avlepage/Glove-PCB/rendered_pcb.png

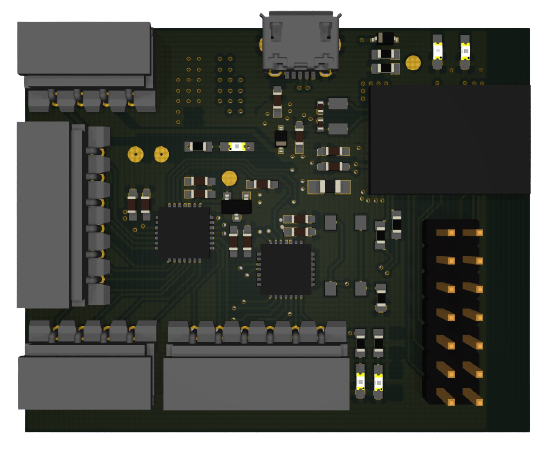
rendered_pcb.png
