avlepage/Glove-PCB/3D/10118194c.stp

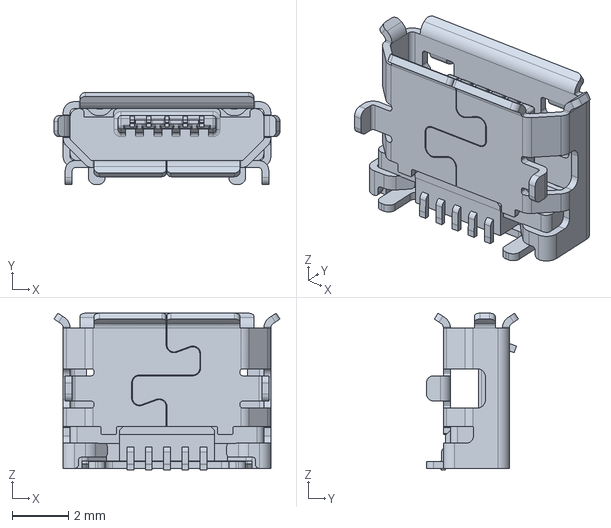
[picture p2: CAD file, 2020-12-24]
3D/10118194c.stp
8.05 x 3.27 x 5.58 mm
