avlepage/Glove-PCB/3D/022057045.stp

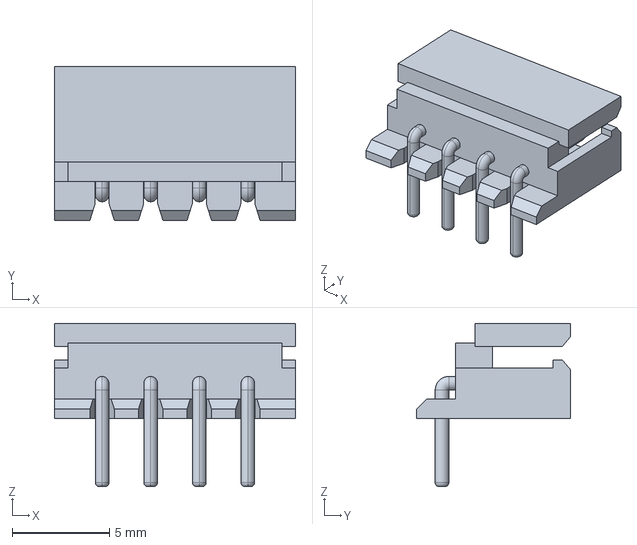
[picture p3: CAD file, 2020-12-24]
3D/022057045.stp
12.4 x 7.90 x 8.40 mm
