avlepage/Glove-PCB/3D/022057065.stp

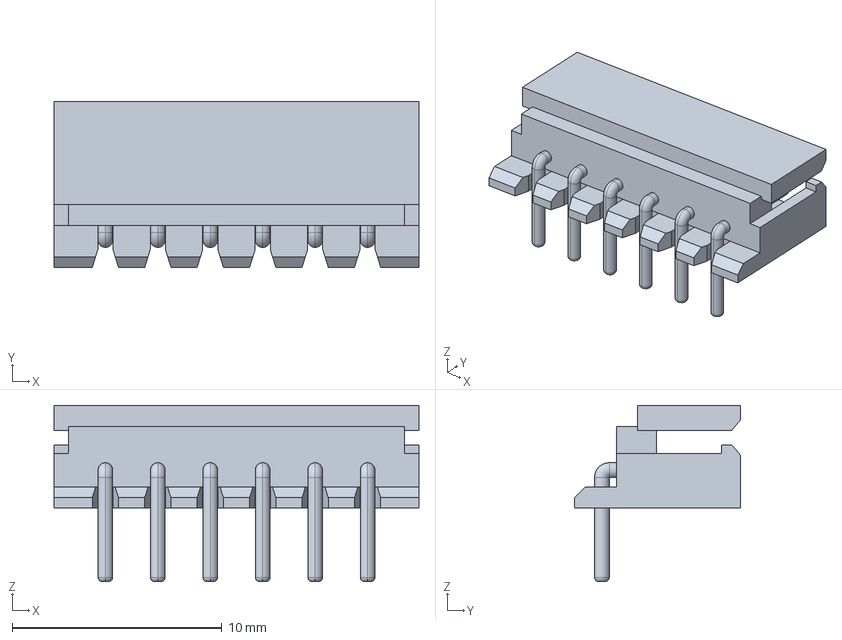
[picture p4: CAD file, 2020-12-24]
3D/022057065.stp
17.4 x 7.90 x 8.40 mm
