avlepage/Glove-PCB/Glove PCB.kicad_pcb

## KiCad design Glove PCB.kicad_pcb (2021-01-22)

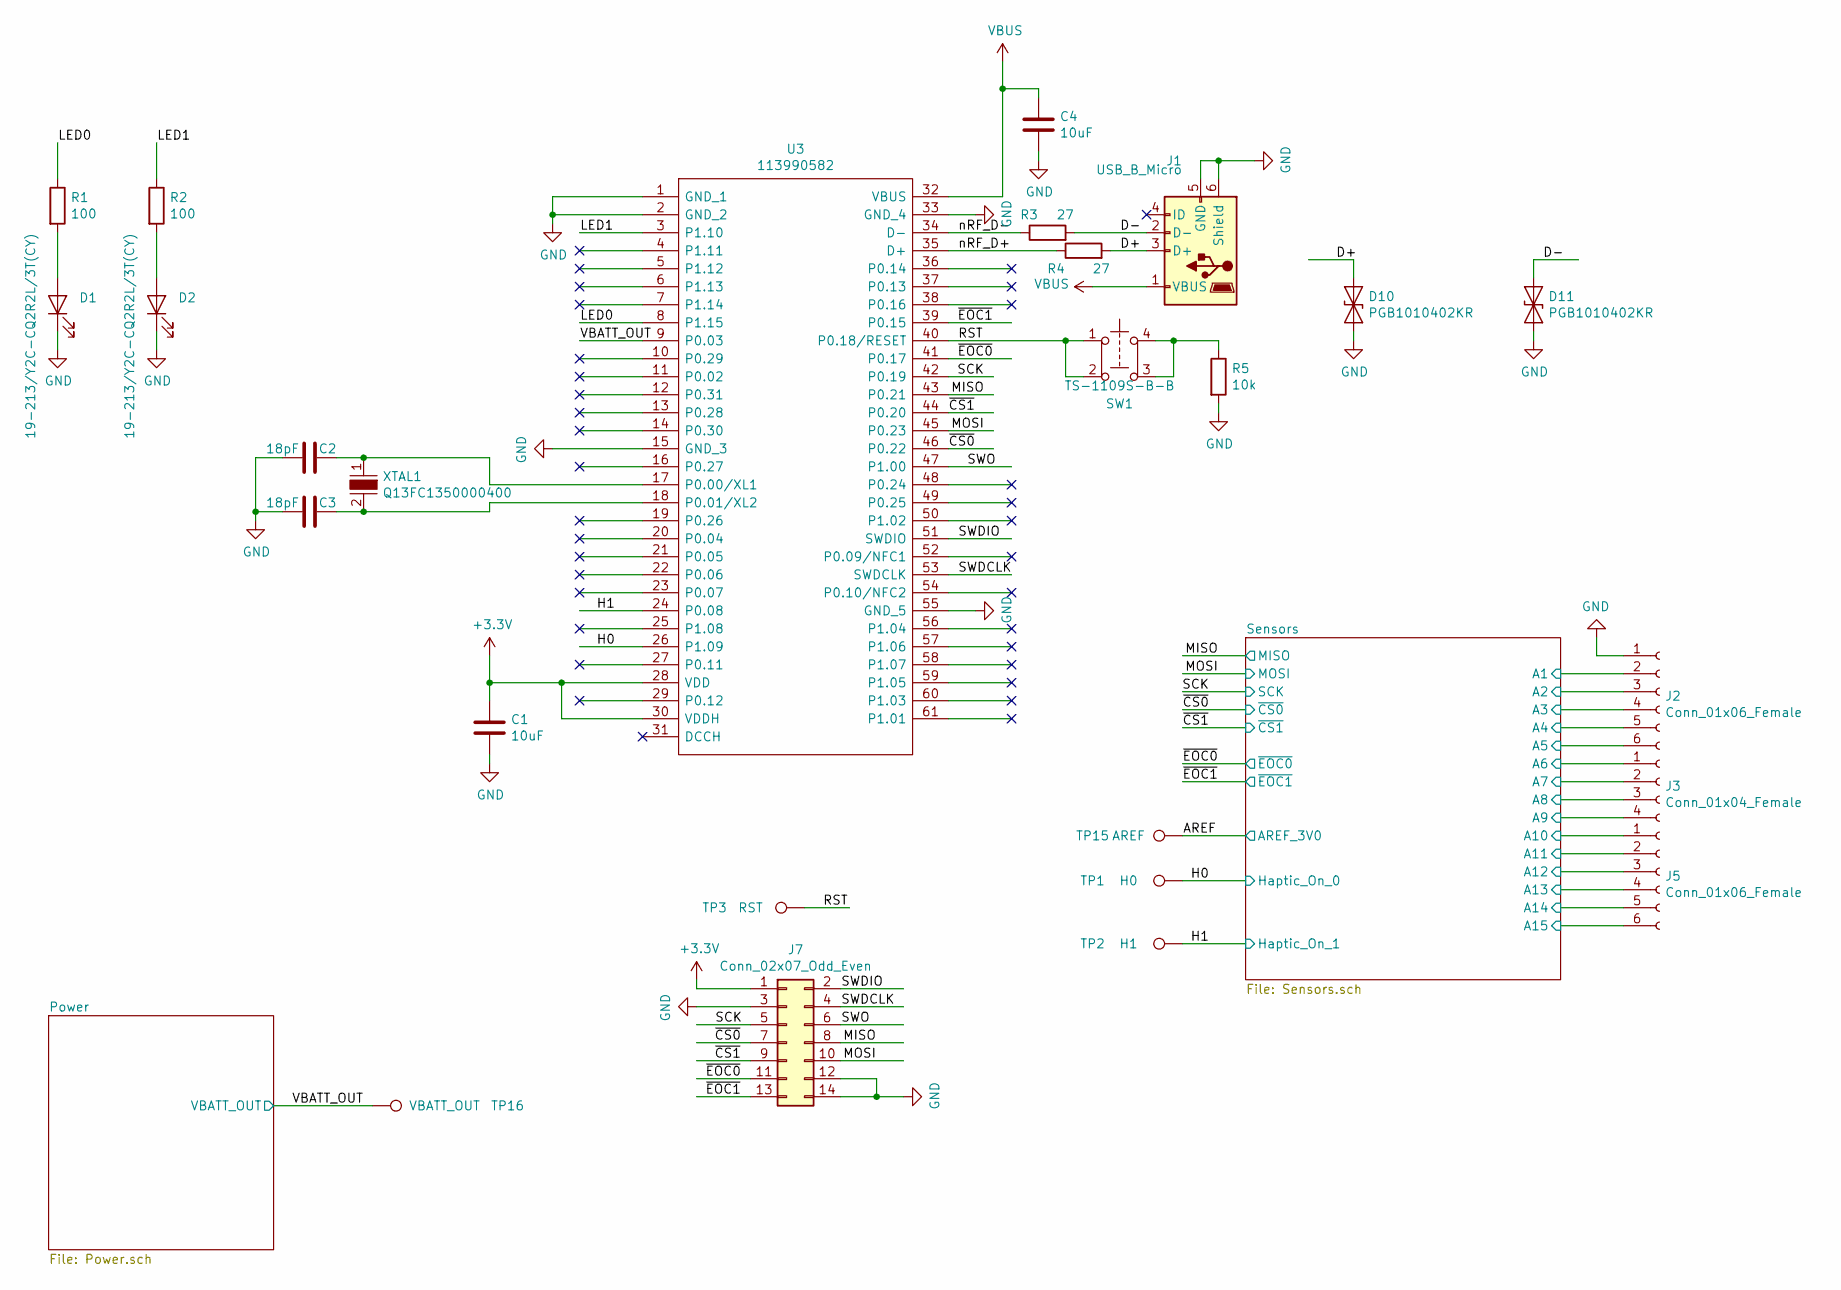
[picture p5: schematic Glove PCB.sch]

Parts:
C1, C4: 10uF; C_0603_HandSoldering; MPN CL10A106KP8NNNC; LCSC C19702
C2, C3: 18pF; C_0402; MPN 0402CG180J500NT; LCSC C1549
D1, D2: 19-213/Y2C-CQ2R2L/3T(CY); LED_0603_HandSoldering; MPN 19-213/Y2C-CQ2R2L/3T(CY); LCSC C72038
D10, D11: PGB1010402KR; D_0402_1005Metric; MPN PGB1010402KR; LCSC C10676
J1: USB_B_Micro; USB_Micro-B_10118194-0001LF
J2, J5: Conn_01x06_Female; 22-05-7065
J3: Conn_01x04_Female; 22-05-7045
J7: Conn_02x07_Odd_Even; PinHeader_2x07_P2.54mm_Vertical
R1, R2: 100; R_0603_HandSoldering; MPN 0603WAF1000T5E; LCSC C22775
R3, R4: 27; R_0603_1608Metric_Pad0.84x1.00mm_HandSolder; MPN 0603WAF270JT5E; LCSC C25190
R5: 10k; R_0402_1005Metric; MPN 0402WGF1002TCE; LCSC C25744
SW1: TS-1109S-B-B; Button; MPN TS-1109S-B-B; LCSC C480315
TP1: H0; TestPoint_Pad_D1.5mm
TP2: H1; TestPoint_Pad_D1.5mm
TP3: RST; TestPoint_Pad_D1.5mm
TP15: AREF; TestPoint_Pad_D1.5mm
TP16: VBATT_OUT; TestPoint_Pad_D1.5mm
U3: 113990582; Mouser Part Number 713-113990582
XTAL1: Q13FC1350000400; Crystal_SMD_G8-2pin_3.2x1.5mm; MPN Q13FC1350000400; Digi-Key_PN XC1617CT-ND

Connections:
+3V3: C1.1, J7.1, U3.28 (VDD), U3.30 (VDDH); also elsewhere on the board
/AREF: TP15.1; also elsewhere on the board
/D+: D10.1 (A1), J1.3 (D+), R4.2
/D-: D11.1 (A1), J1.2 (D-), R3.2
/H0: TP1.1, U3.26 (P1.09); also elsewhere on the board
/H1: TP2.1, U3.24 (P0.08); also elsewhere on the board
/LED0: R1.1, U3.8 (P1.15)
/LED1: R2.1, U3.3 (P1.10)
/MISO: J7.8, U3.43 (P0.21); also elsewhere on the board
/MOSI: J7.10, U3.45 (P0.23); also elsewhere on the board
/RST: SW1.1, SW1.2, TP3.1, U3.40 (P0.18/RESET); also elsewhere on the board
/SCK: J7.5, U3.42 (P0.19); also elsewhere on the board
/SWDCLK: J7.4, U3.53 (SWDCLK)
/SWDIO: J7.2, U3.51 (SWDIO)
/SWO: J7.6, U3.47 (P1.00)
/Sensors/A1: J2.2; also elsewhere on the board
/Sensors/A2: J2.3; also elsewhere on the board
/Sensors/A3: J2.4; also elsewhere on the board
/Sensors/A4: J2.5; also elsewhere on the board
/Sensors/A5: J2.6; also elsewhere on the board
/Sensors/A6: J3.1; also elsewhere on the board
/Sensors/A7: J3.2; also elsewhere on the board
/Sensors/A8: J3.3; also elsewhere on the board
/Sensors/A9: J3.4; also elsewhere on the board
/Sensors/A10: J5.1; also elsewhere on the board
/Sensors/A11: J5.2; also elsewhere on the board
/Sensors/A12: J5.3; also elsewhere on the board
/Sensors/A13: J5.4; also elsewhere on the board
/Sensors/A14: J5.5; also elsewhere on the board
/Sensors/A15: J5.6; also elsewhere on the board
/VBATT_OUT: TP16.1, U3.9 (P0.03); also elsewhere on the board
/nRF_D+: R4.1, U3.35 (D+)
/nRF_D-: R3.1, U3.34 (D-)
/~CS0: J7.7, U3.46 (P0.22); also elsewhere on the board
/~CS1: J7.9, U3.44 (P0.20); also elsewhere on the board
/~EOC0: J7.11, U3.41 (P0.17); also elsewhere on the board
/~EOC1: J7.13, U3.39 (P0.15); also elsewhere on the board
GND: C1.2, C2.2, C3.2, C4.2, D1.1 (K), D2.1 (K), D10.2 (A2), D11.2 (A2), J1.5 (GND), J1.6 (Shield), J2.1, J7.3, J7.12, J7.14, R5.2, U3.1 (GND_1), U3.2 (GND_2), U3.15 (GND_3), U3.33 (GND_4), U3.55 (GND_5); also elsewhere on the board
unnamed: C2.1, U3.17 (P0.00/XL1), XTAL1.1
unnamed: C3.1, U3.18 (P0.01/XL2), XTAL1.2
unnamed: D1.2 (A), R1.2
unnamed: D2.2 (A), R2.2
unnamed: R5.1, SW1.3, SW1.4
VBUS: C4.1, J1.1 (VBUS), U3.32 (VBUS); also elsewhere on the board

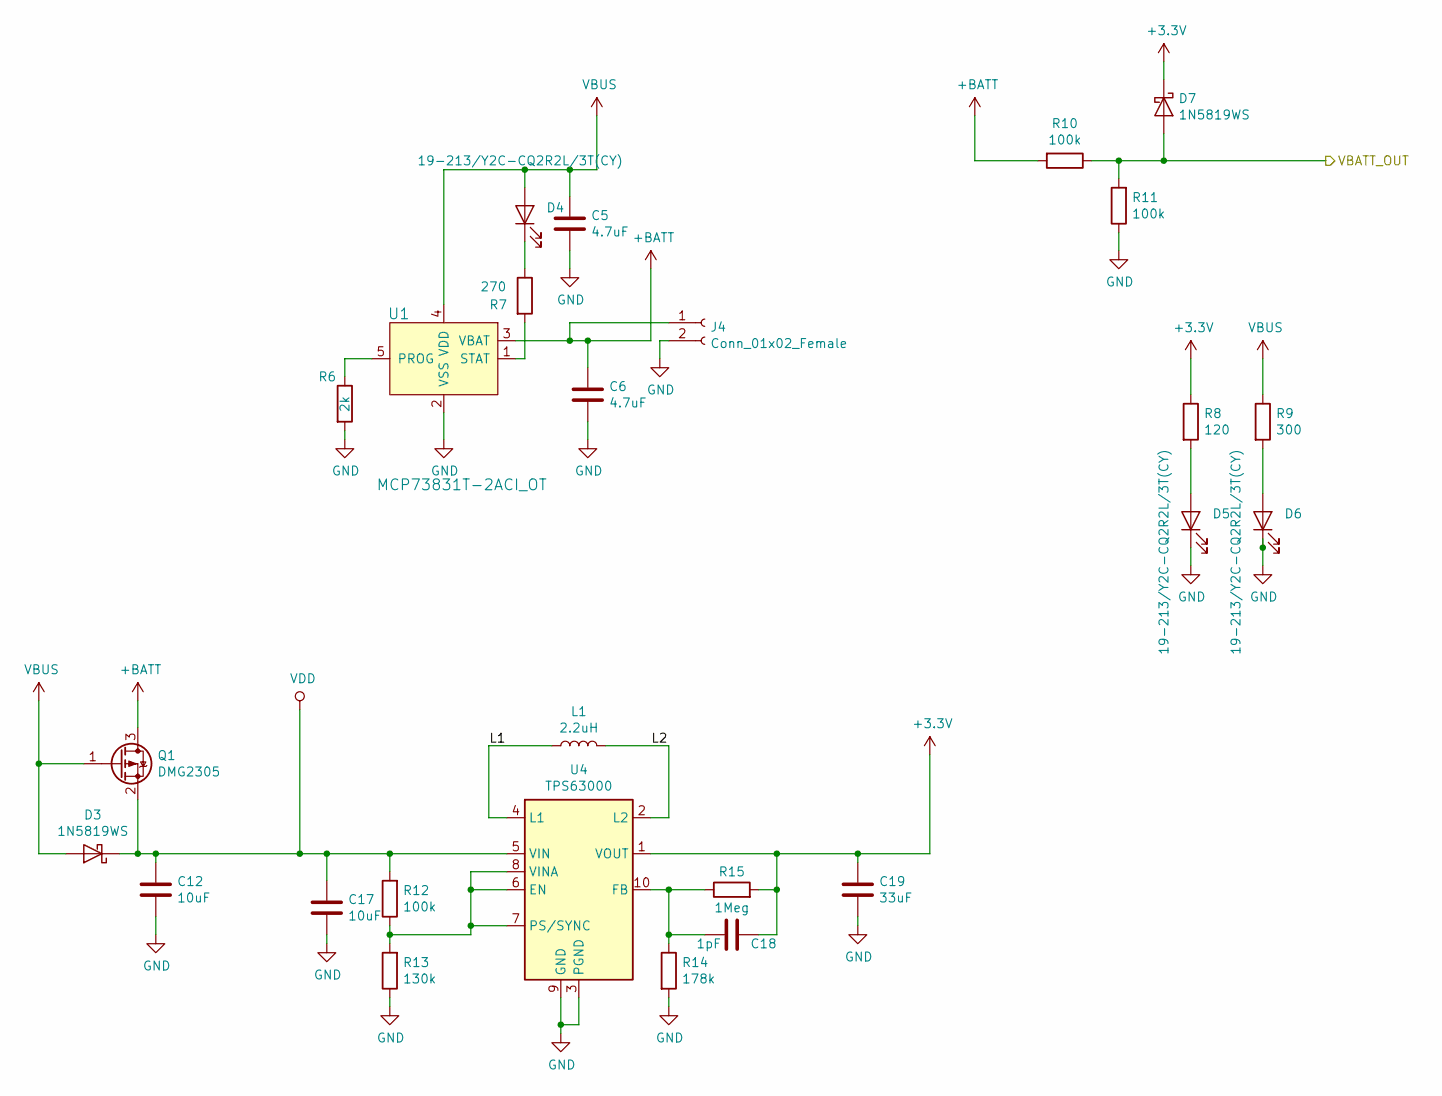
[picture p6: schematic Power.sch]

Parts:
C5, C6: 4.7uF; C_0603_HandSoldering; MPN CL10A475KO8NNNC; LCSC C19666
C12, C17: 10uF; C_0603_HandSoldering; MPN CL10A106KP8NNNC; LCSC C19702
C18: 1pF; C_0603_HandSoldering; MPN CL10C010CB8NNNC; LCSC C23969
C19: 33uF; C_0805_HandSoldering; MPN C2012X5R1A336MTJ00E; LCSC C342635
D3, D7: 1N5819WS; D_SOD-323; MPN 1N5819WS; LCSC C191023
D4, D5, D6: 19-213/Y2C-CQ2R2L/3T(CY); LED_0603_HandSoldering; MPN 19-213/Y2C-CQ2R2L/3T(CY); LCSC C72038
J4: Conn_01x02_Female; JST_PH_B2B-PH-SM4-TB_1x02_P2.00mm_Vertical
L1: 2.2uH; L_0805_HandSoldering; MPN MPH201210S2R2MT; LCSC C55755
Q1: DMG2305; SOT-23; MPN DMG2305UX-13; LCSC C144153
R6: 2k; R_0402_1005Metric; MPN 0402WGF2001TCE; LCSC C4109
R7: 270; R_0603_HandSoldering; MPN 0603WAF2700T5E; LCSC C22966
R8: 120; R_0603_HandSoldering; MPN 0603WAF1200T5E; LCSC C22787
R9: 300; R_0603_HandSoldering; MPN 0603WAF3000T5E; LCSC C23025
R10, R11, R12: 100k; R_0603_HandSoldering; MPN 0603WAF1003T5E; LCSC C25803
R13: 130k; R_0603_HandSoldering; MPN 0603WAF1303T5E; LCSC C22795
R14: 178k; R_0603_HandSoldering; MPN 0603WAF1783T5E; LCSC C22823
R15: 1Meg; R_0603_HandSoldering; MPN 0603WAF1004T5E; LCSC C22935
U1: MCP73831T-2ACI_OT; SOT-753; MPN MCP73831T-2ACI/OT; Digi-Key_PN MCP73831T-2ACI/OTCT-ND
U4: TPS63000; VSON-10-1EP_3x3mm_P0.5mm_EP1.65x2.4mm_ThermalVias; MPN TPS63000DRCR; LCSC C24966

Connections:
+3V3: C18.1, C19.1, D7.1 (K), R8.1, R15.2, U4.1 (VOUT); also elsewhere on the board
+BATT: C6.1, J4.1, Q1.3 (D), R10.2, U1.3 (VBAT)
/Power/L1: L1.1, U4.4 (L1)
/Power/L2: L1.2, U4.2 (L2)
/VBATT_OUT: D7.2 (A), R10.1, R11.2; also elsewhere on the board
GND: C5.2, C6.2, C12.2, C17.2, C19.2, D5.1 (K), D6.1 (K), J4.2, R6.2, R11.1, R13.1, R14.2, U1.2 (VSS), U4.3 (PGND), U4.9 (GND), U4.11 (PGND); also elsewhere on the board
unnamed: C18.2, R14.1, R15.1, U4.10 (FB)
unnamed: D4.1 (K), R7.1
unnamed: D5.2 (A), R8.2
unnamed: D6.2 (A), R9.2
unnamed: R6.1, U1.5 (PROG)
unnamed: R7.2, U1.1 (STAT)
unnamed: R12.1, R13.2, U4.6 (EN), U4.7 (PS/SYNC), U4.8 (VINA)
VBUS: C5.1, D3.2 (A), D4.2 (A), Q1.1 (G), R9.1, U1.4 (VDD); also elsewhere on the board
VDD: C12.1, C17.1, D3.1 (K), Q1.2 (S), R12.2, U4.5 (VIN); also elsewhere on the board

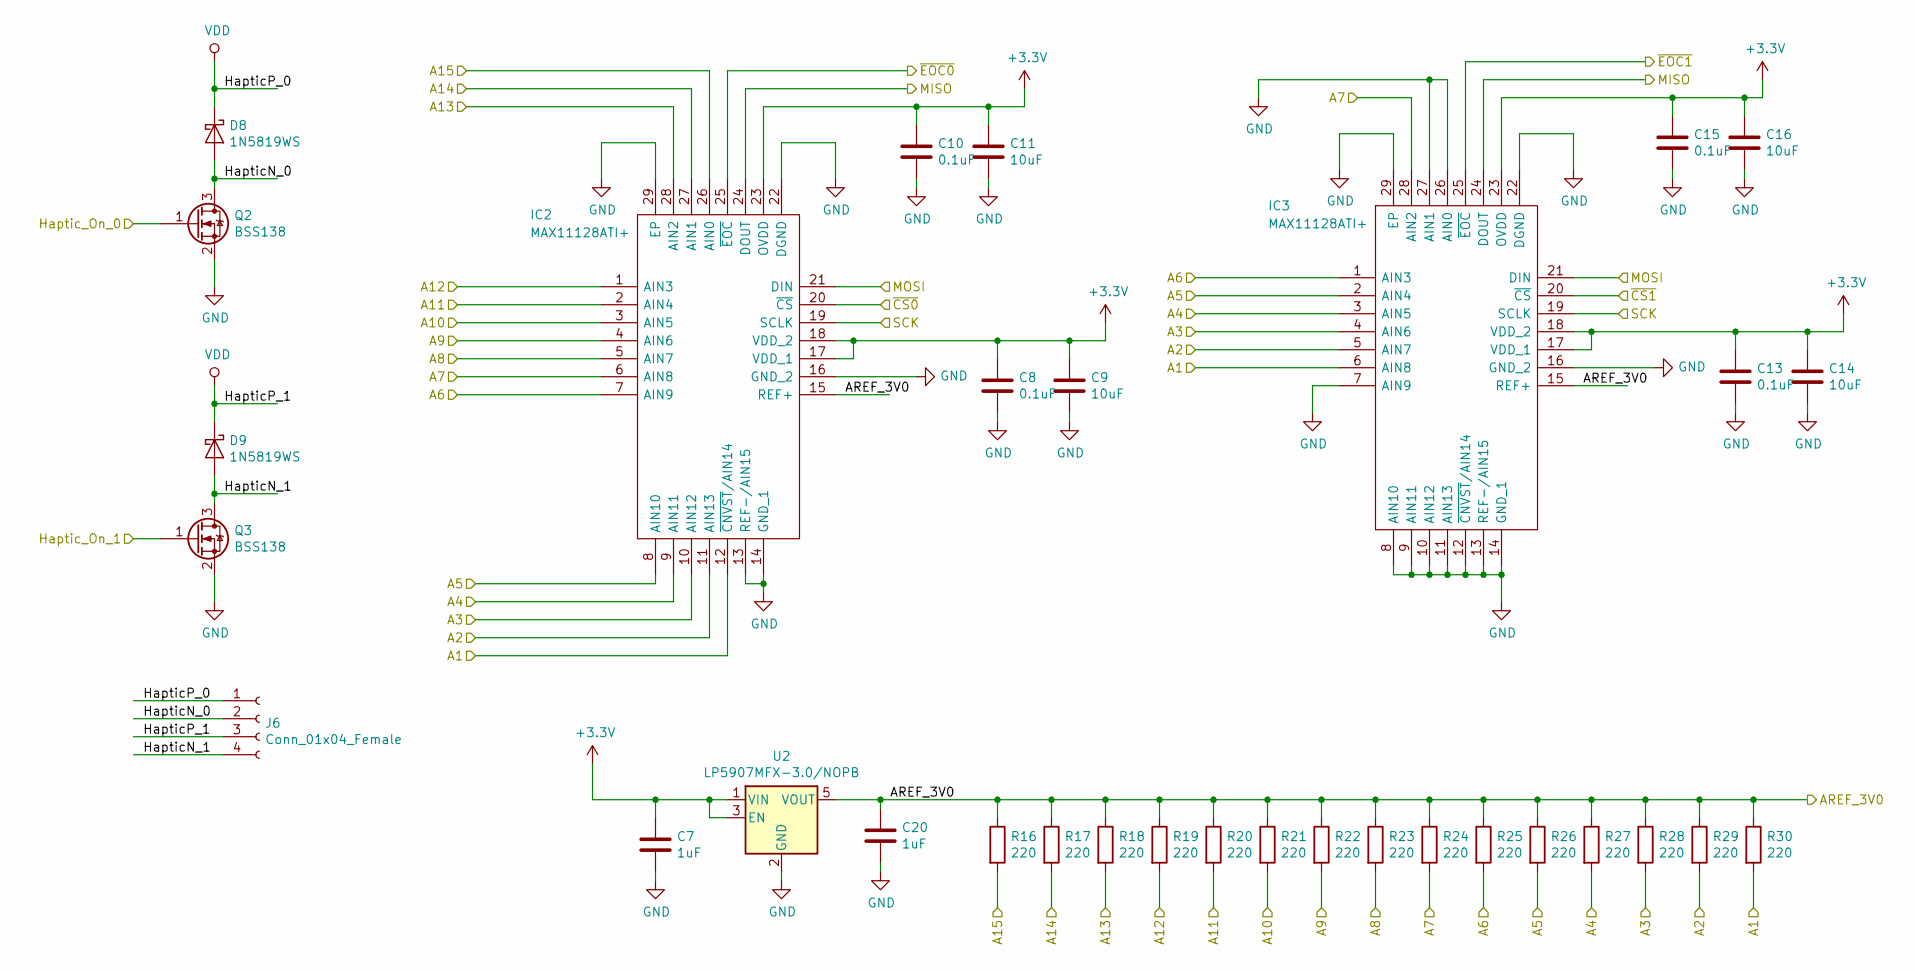
[picture p7: schematic Sensors.sch]

Parts:
C7, C20: 1uF; C_0603_HandSoldering; MPN CL10A105KB8NNNC; LCSC C15849
C8, C10, C13, C15: 0.1uF; C_0603_HandSoldering; MPN CC0603KRX7R9BB104; LCSC C14663
C9, C11, C14, C16: 10uF; C_0603_HandSoldering; MPN CL10A106KP8NNNC; LCSC C19702
D8, D9: 1N5819WS; D_SOD-323; MPN 1N5819WS; LCSC C191023
IC2, IC3: MAX11128ATI+; QFN50P500X500X80-29N; Mouser Part Number 700-MAX11128ATI+
J6: Conn_01x04_Female; 22-05-7045
Q2, Q3: BSS138; SOT-23; MPN BSS138; LCSC C52895
R16, R17, R18, R19, R20, R21, R22, R23, R24, R25, R26, R27, R28, R29, R30: 220; R_0603_HandSoldering; MPN 0603WAF2200T5E; LCSC C22962
U2: LP5907MFX-3.0/NOPB; SOT-23-5; MPN LP5907MFX-3.0/NOPB; LCSC C475492

Connections:
+3V3: C7.1, C8.1, C9.1, C10.1, C11.1, C13.1, C14.1, C15.1, C16.1, IC2.17 (VDD_1), IC2.18 (VDD_2), IC2.23 (OVDD), IC3.17 (VDD_1), IC3.18 (VDD_2), IC3.23 (OVDD), U2.1 (VIN), U2.3 (EN); also elsewhere on the board
/AREF: C20.1, IC2.15 (REF+), IC3.15 (REF+), R16.1, R17.1, R18.1, R19.1, R20.1, R21.1, R22.1, R23.1, R24.1, R25.1, R26.1, R27.1, R28.1, R29.1, R30.1, U2.5 (VOUT); also elsewhere on the board
/H0: Q2.1 (G); also elsewhere on the board
/H1: Q3.1 (G); also elsewhere on the board
/MISO: IC2.24 (DOUT), IC3.24 (DOUT); also elsewhere on the board
/MOSI: IC2.21 (DIN), IC3.21 (DIN); also elsewhere on the board
/SCK: IC2.19 (SCLK), IC3.19 (SCLK); also elsewhere on the board
/Sensors/A1: IC2.12 (~CNVST~/AIN14), IC3.6 (AIN8), R30.2; also elsewhere on the board
/Sensors/A2: IC2.11 (AIN13), IC3.5 (AIN7), R29.2; also elsewhere on the board
/Sensors/A3: IC2.10 (AIN12), IC3.4 (AIN6), R28.2; also elsewhere on the board
/Sensors/A4: IC2.9 (AIN11), IC3.3 (AIN5), R27.2; also elsewhere on the board
/Sensors/A5: IC2.8 (AIN10), IC3.2 (AIN4), R26.2; also elsewhere on the board
/Sensors/A6: IC2.7 (AIN9), IC3.1 (AIN3), R25.2; also elsewhere on the board
/Sensors/A7: IC2.6 (AIN8), IC3.28 (AIN2), R24.2; also elsewhere on the board
/Sensors/A8: IC2.5 (AIN7), R23.2; also elsewhere on the board
/Sensors/A9: IC2.4 (AIN6), R22.2; also elsewhere on the board
/Sensors/A10: IC2.3 (AIN5), R21.2; also elsewhere on the board
/Sensors/A11: IC2.2 (AIN4), R20.2; also elsewhere on the board
/Sensors/A12: IC2.1 (AIN3), R19.2; also elsewhere on the board
/Sensors/A13: IC2.28 (AIN2), R18.2; also elsewhere on the board
/Sensors/A14: IC2.27 (AIN1), R17.2; also elsewhere on the board
/Sensors/A15: IC2.26 (AIN0), R16.2; also elsewhere on the board
/Sensors/HapticN_0: D8.2 (A), J6.2, Q2.3 (D); also elsewhere on the board
/Sensors/HapticN_1: D9.2 (A), J6.4, Q3.3 (D); also elsewhere on the board
/~CS0: IC2.20 (~CS); also elsewhere on the board
/~CS1: IC3.20 (~CS); also elsewhere on the board
/~EOC0: IC2.25 (~EOC); also elsewhere on the board
/~EOC1: IC3.25 (~EOC); also elsewhere on the board
GND: C7.2, C8.2, C9.2, C10.2, C11.2, C13.2, C14.2, C15.2, C16.2, C20.2, IC2.13 (REF-/AIN15), IC2.14 (GND_1), IC2.16 (GND_2), IC2.22 (DGND), IC2.29 (EP), IC3.7 (AIN9), IC3.8 (AIN10), IC3.9 (AIN11), IC3.10 (AIN12), IC3.11 (AIN13), IC3.12 (~CNVST~/AIN14), IC3.13 (REF-/AIN15), IC3.14 (GND_1), IC3.16 (GND_2), IC3.22 (DGND), IC3.26 (AIN0), IC3.27 (AIN1), IC3.29 (EP), Q2.2 (S), Q3.2 (S), U2.2 (GND); also elsewhere on the board
VDD: D8.1 (K), D9.1 (K), J6.1, J6.3; also elsewhere on the board

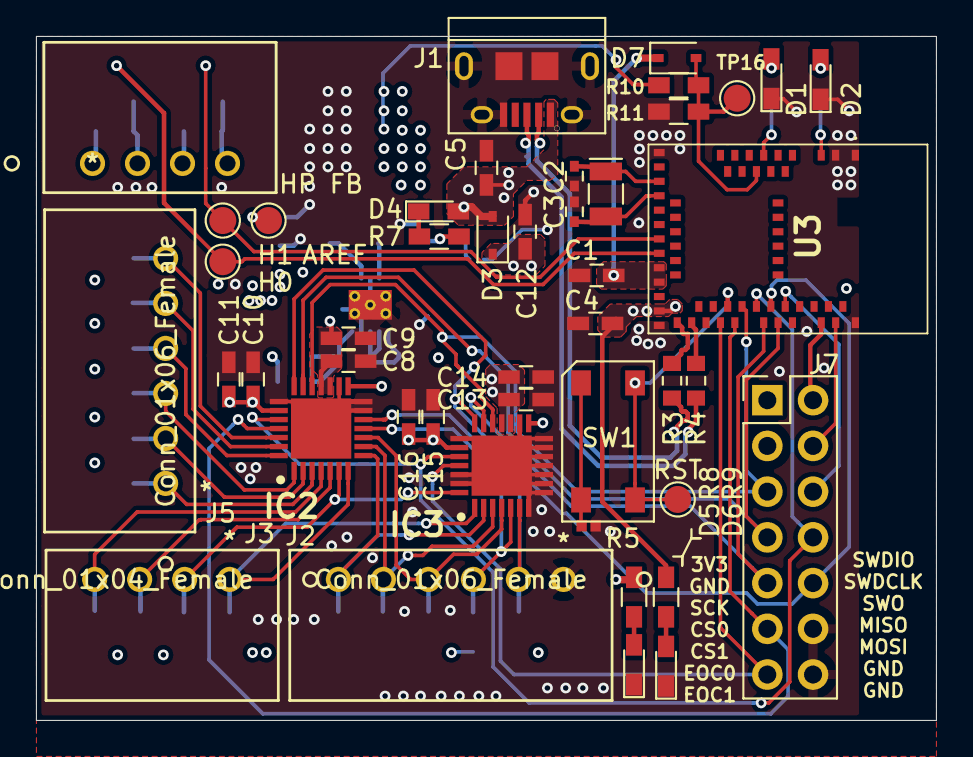
[picture p8: board Glove PCB.kicad_pcb from above]

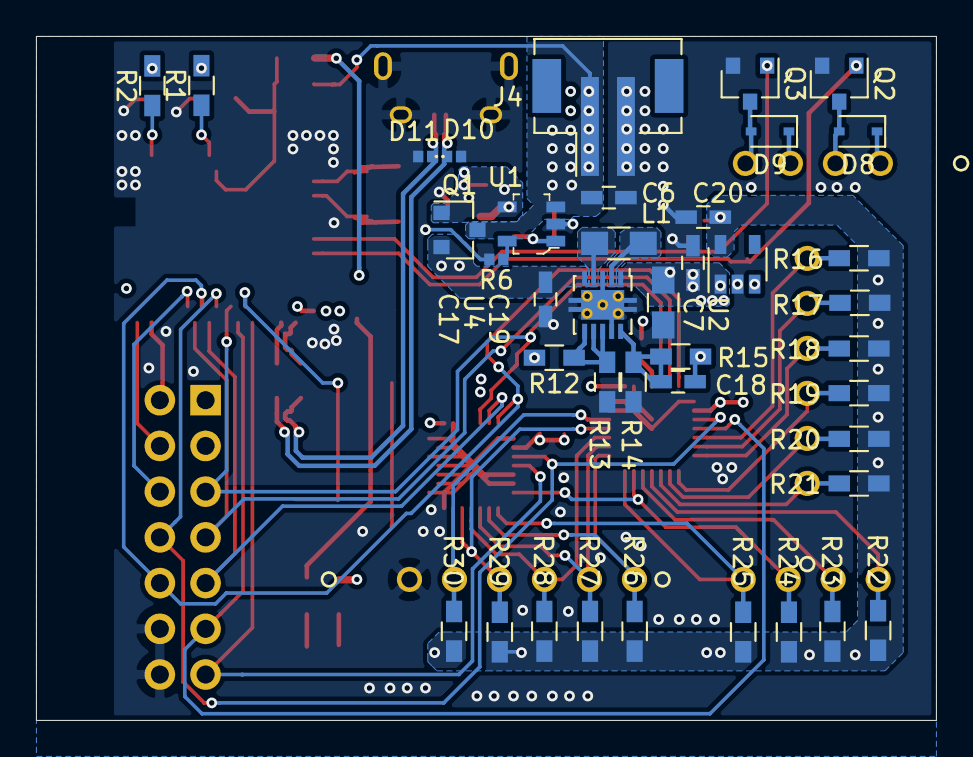
[picture p9: board Glove PCB.kicad_pcb from below]

Board: 4 copper layers, 50.0 x 38.0 mm, 85 parts (40 on the bottom side), 57 nets.

Other parts of the board:
HP FB: Conn_01x04_Female; 22-05-7045
RST: RST; TestPoint_Pad_D1.5mm

Their connections:
/RST: RST.1; also elsewhere on the board
/Sensors/HapticN_0: HP FB.2; also elsewhere on the board
/Sensors/HapticN_1: HP FB.4; also elsewhere on the board
VDD: HP FB.1, HP FB.3; also elsewhere on the board
