avlepage/Glove-PCB/(commit log)

2020-11-18 initial commit to Glove PCB. Schematic started, MCU main power sorted, still need to figure out sensors and actuators as well as the power.
    [Glove PCB.kicad_pcb, Glove PCB.sch, Power.sch, Sensors.sch]
2020-11-18 added LiPo charging circuit
    [Power.sch]
2020-11-22 REAL COMMIT: Completed initial schematic. Added ADCs, Haptic FB circuits, test points, USB/Battery selection circuits.
    [Glove PCB.kicad_pcb, Glove PCB.sch, Power.sch, Sensors.sch]
2020-11-26 Added project and digikey footprints. Added mini-spox connectors.
    [Glove PCB.kicad_pcb, Glove PCB.sch, Power.sch, Sensors.sch, familylist_refdes.csv]
2020-11-29 Placement done. Started layout.
    [Glove PCB.kicad_pcb, Glove PCB.sch, Sensors.sch]
2020-12-10 Changed to 4-layer board, added power shapes in layout.
    [Glove PCB.kicad_pcb, Glove PCB.sch, Sensors.sch]
2020-12-24 Added high side R for sensors and buck-boost. Replaced 3.0V VRef with LDO. BOM rev 1. Finished layout. TODO: Silkscreen.
    [022057045.stp, 022057065.stp, 10118194c.stp, Glove PCB.kicad_pcb, Glove PCB.sch, Power.sch, Sensors.sch]
2020-12-24 Filled copper zone priorities were frickle-frackled, they are fixed now. Still gotta do silk :(
    [Glove PCB.kicad_pcb]
2020-12-24 My nap was too long but finished silk.
    [Glove PCB.kicad_pcb, Glove PCB.sch]
2020-12-24 Add BOM Script and generated picknplace, BOM, & Gerbers. Sent to fabgit add -A!
    [Glove PCB-B_Cu.gbr, Glove PCB-B_Mask.gbr, Glove PCB-B_Paste.gbr, Glove PCB-B_SilkS.gbr, Glove PCB-Edge_Cuts.gbr, Glove PCB-F_Cu.gbr, Glove PCB-F_Mask.gbr, Glove PCB-F_Paste.gbr]
